Blizbor/KDAC/Hardware/Output/dac.pdf

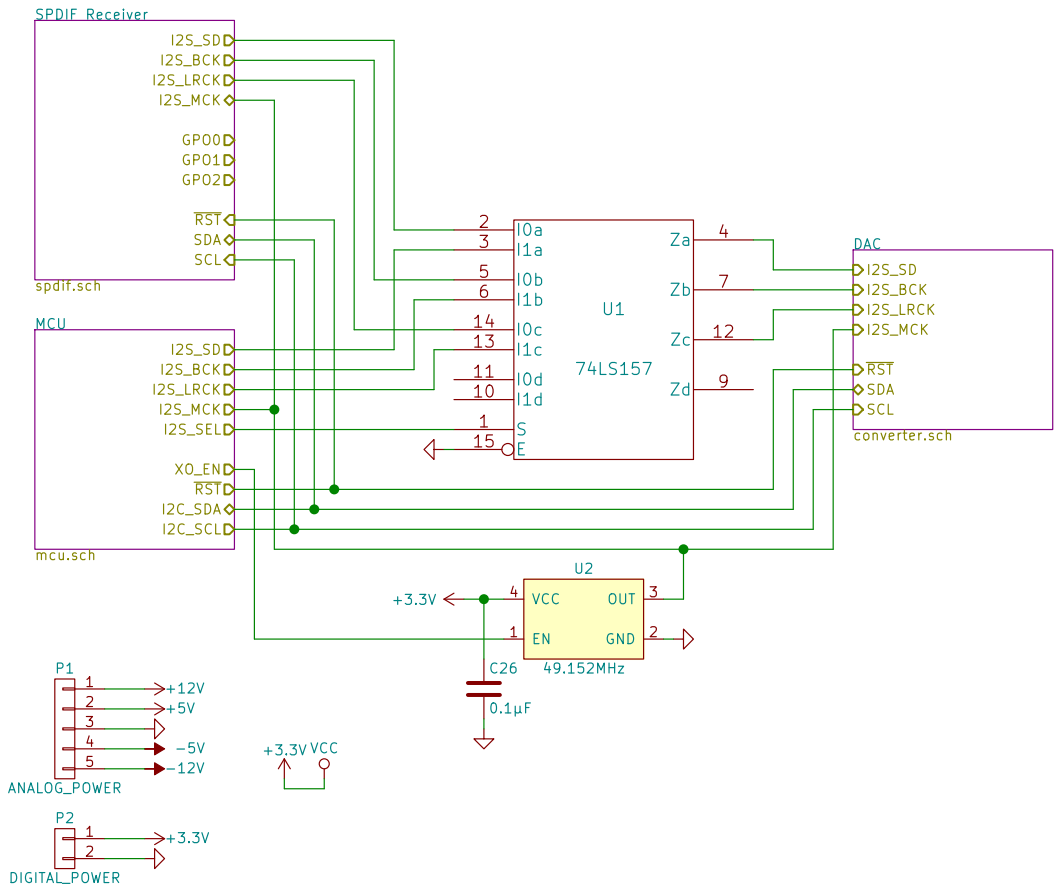
[picture p1: page 1]

File: dac.sch Sheet: / Kosyak CC BY-SA S

Id: 1/4 Title: KDAC - OpenSource USB Audio DAC

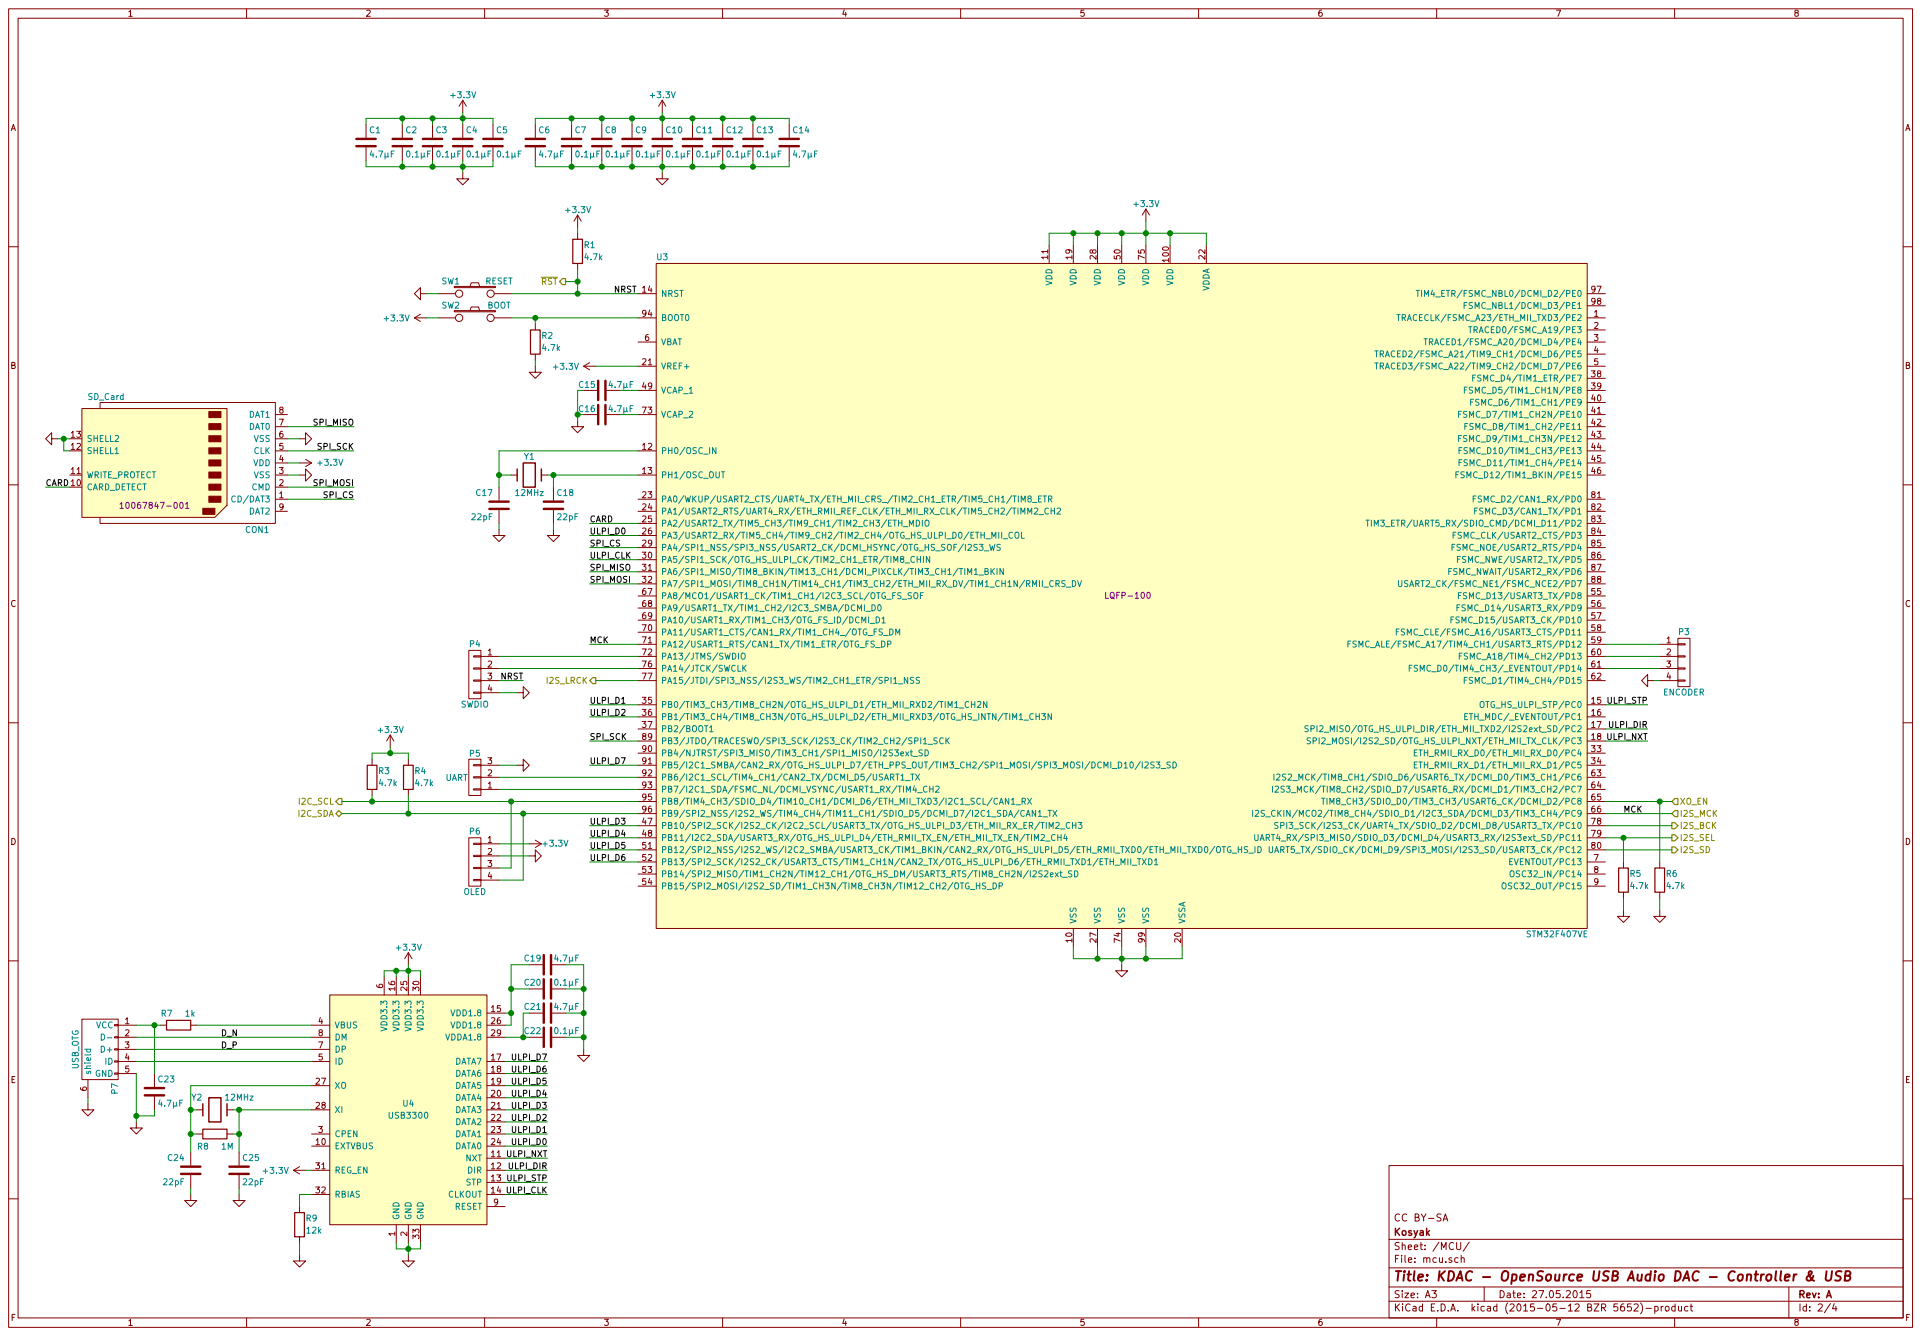
[picture p2: page 2]

6 DP 7 DM 8 RESET 9 EXTVBUS 10 DATA4 20 VDD3.3 30 NXT 11 DATA3 21 REG_EN 31 DIR 12 DATA2 22 RBIAS 32 STP 13 DATA1 23 GND 33 CLKOUT 14 DATA0 24 VDD1.8 15 VDD3.3 25 VDD3.3 16 VDD1.8 26 DATA7 17 XO 27 DATA6 18 XI 28 DATA5 19 VDDA1.8 29 U4 USB3300

File: mcu.sch Sheet: /MCU/ Kosyak CC BY-SA

Id: 2/4 Title: KDAC - OpenSource USB Audio DAC - Controller & USB

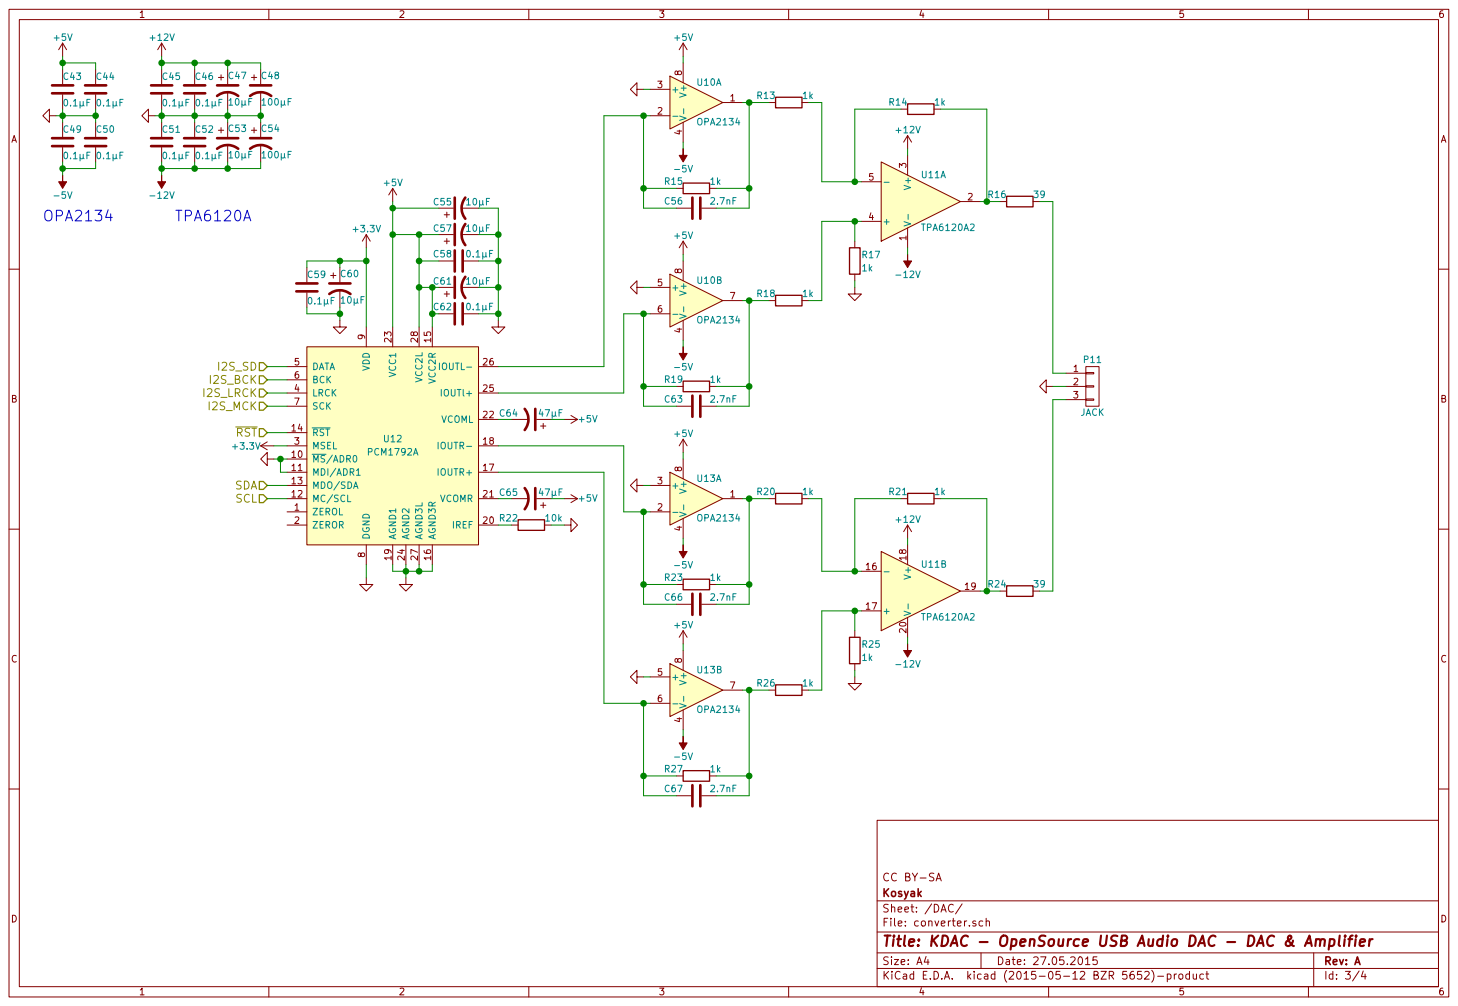
[picture p3: page 3]

Id: 3/4 Title: KDAC - OpenSource USB Audio DAC - DAC & Amplifier File: converter.sch Sheet: /DAC/ Kosyak CC BY-SA

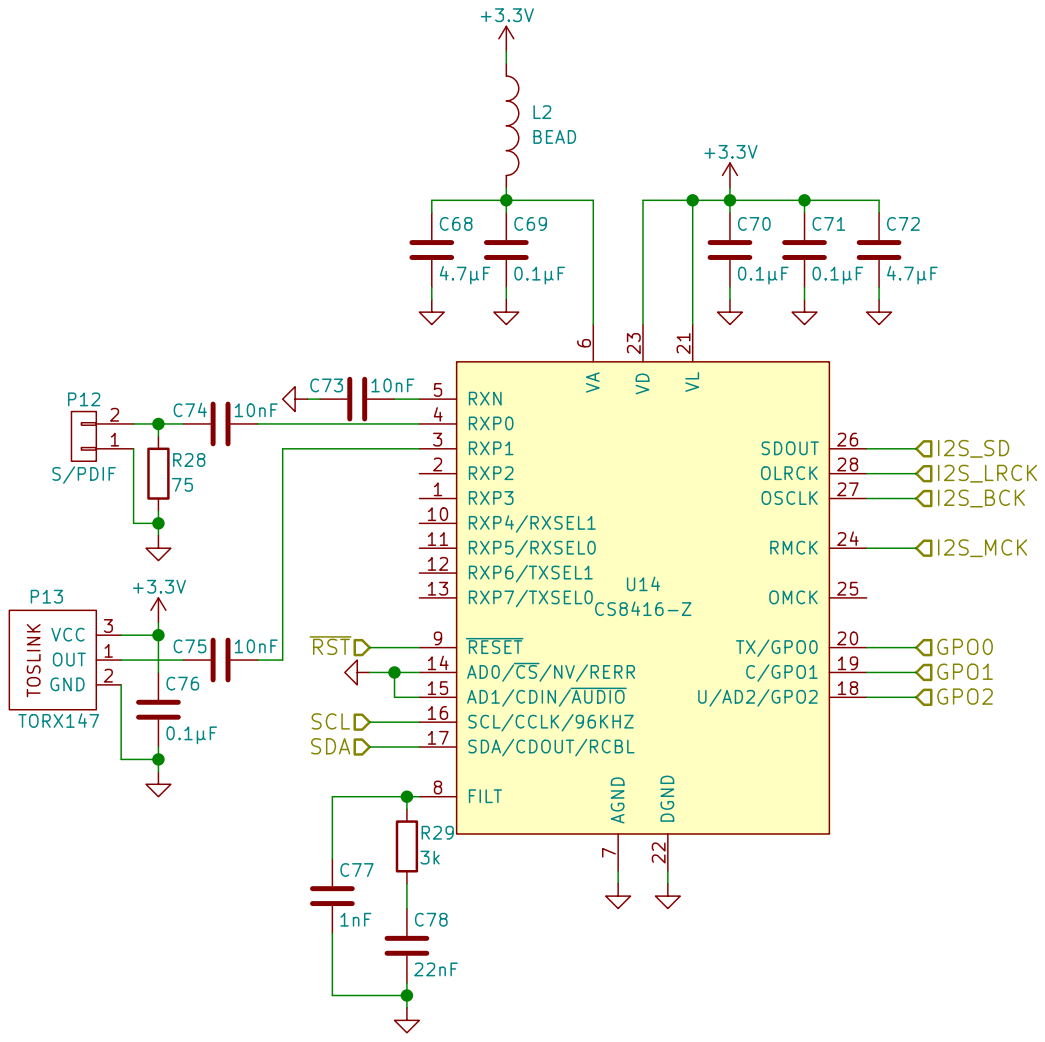
[picture p4: page 4]

7 FILT 8 RESET 9 RXP4/RXSEL1 10 TX/GPO0 20 RXP5/RXSEL0 11 VL 21 RXP6/TXSEL1 12 DGND 22 RXP7/TXSEL0 13 VD 23 AD0/CS/NV/RERR 14 RMCK 24 AD1/CDIN/AUDIO 15 OMCK 25 SCL/CCLK/96KHZ 16 SDOUT 26 SDA/CDOUT/RCBL 17 OSCLK 27 U/AD2/GPO2 18 OLRCK 28 C/GPO1 19 U14 CS8416-Z C69

File: spdif.sch Sheet: /SPDIF Receiver/ Kosyak CC BY-SA

Id: 4/4 Title: KDAC - OpenSource USB Audio DAC - S/PDIF Receiver
