Blizbor/KDAC/Hardware/dac.kicad_pcb

## KiCad design Hardware/dac.kicad_pcb (2015-05-27)

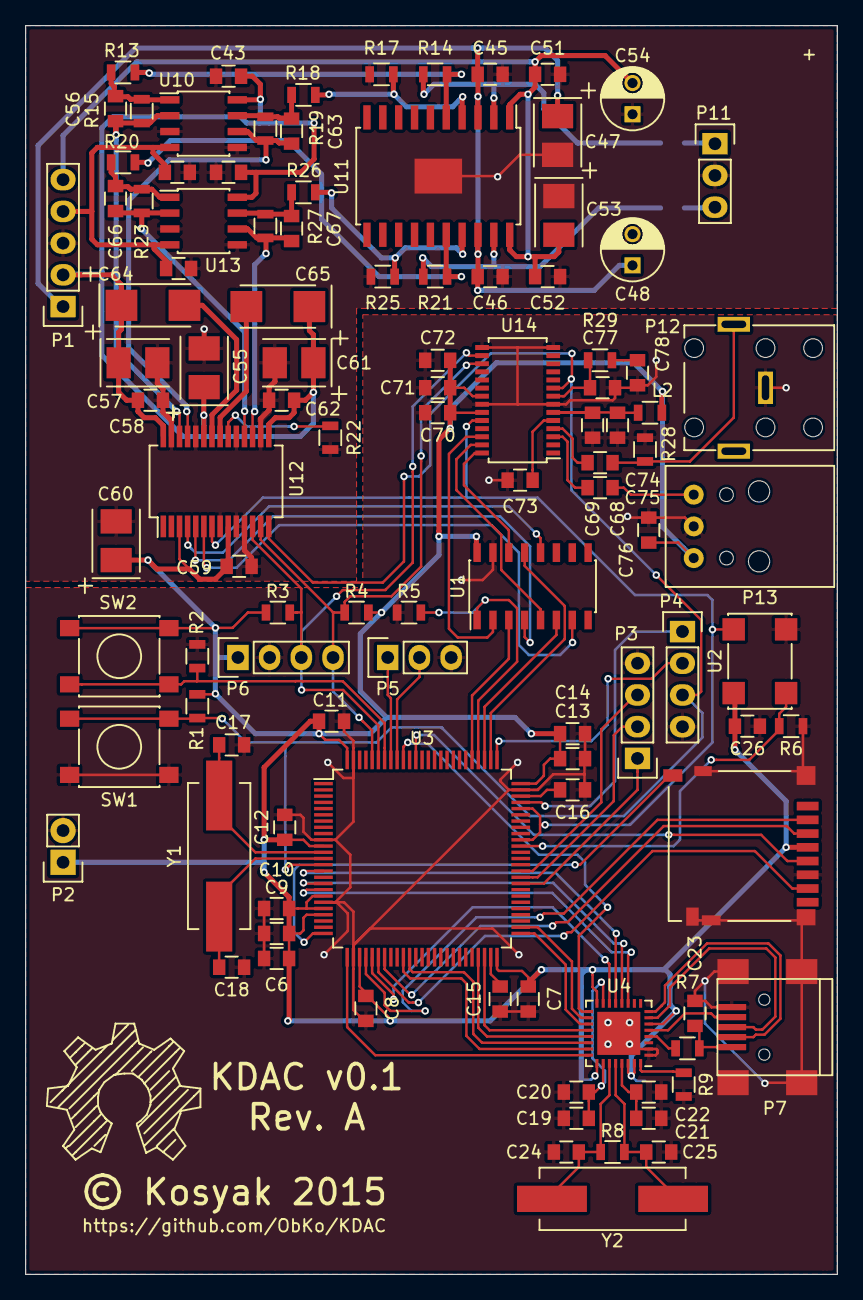
[picture p5: board dac.kicad_pcb from above]

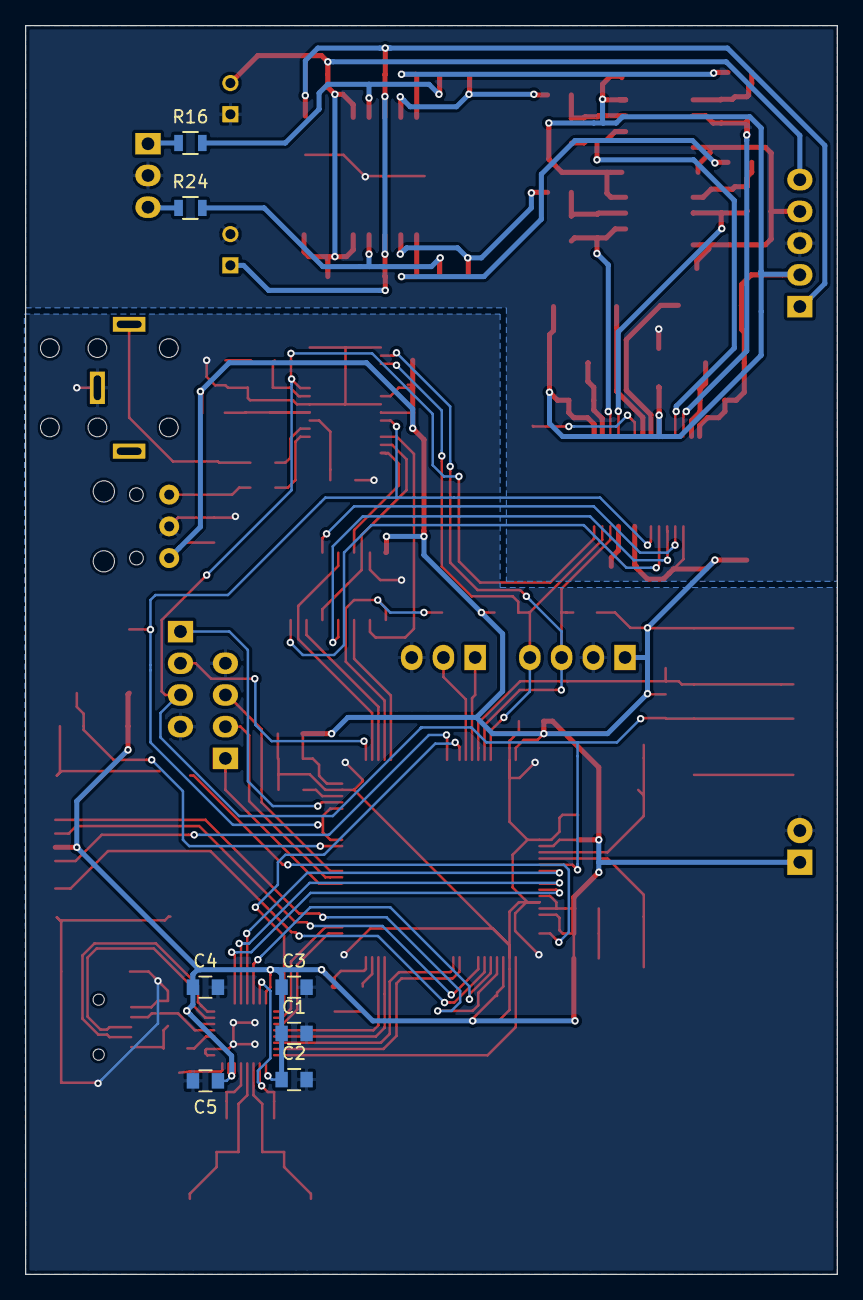
[picture p6: board dac.kicad_pcb from below]

Board: 2 copper layers, 65.0 x 100.0 mm, 113 parts (7 on the bottom side), 88 nets.

Parts:
C1, C6, C14, C15, C16, C19, C21, C23, C68, C72: 4.7µF; C_0805
C2, C3, C4, C5, C7, C8, C9, C10, C11, C12, C13, C20, C22, C26, C43, C44, C45, C46, C49, C50, C51, C52, C58, C59, C62, C69, C70, C71, C76: 0.1µF; C_0805
C17, C18, C24, C25: 22pF; C_0805
C47, C53, C55, C57, C60, C61: 10µF; TantalC_SizeB_EIA-3528_Reflow
C48, C54: 100µF; C_Radial_D5_L11_P2.5
C56, C63, C66, C67: 2.7nF; C_0805
C64, C65: 47µF; TantalC_SizeC_EIA-6032_Reflow
C73, C74, C75: 10nF; C_0805
C77: 1nF; C_0805
C78: 22nF; C_0805
CON1: SD_Card; DM3D-SF
L2: BEAD; R_0805
P1: ANALOG_POWER; Pin_Header_Straight_1x05
P2: DIGITAL_POWER; Pin_Header_Straight_1x02
P3: ENCODER; Pin_Header_Straight_1x04
P4: SWDIO; Pin_Header_Straight_1x04
P5: UART; Pin_Header_Straight_1x03
P6: OLED; Pin_Header_Straight_1x04
P7: USB_OTG; USB_Mini-B
P11: JACK; Pin_Header_Straight_1x03
P12: S/PDIF; RCA
P13: TORX147; TORX147PL
R1, R2, R3, R4, R5, R6: 4.7k; R_0805
R7, R13, R14, R15, R17, R18, R19, R20, R21, R23, R25, R26, R27: 1k; R_0805
R8: 1M; R_0805
R9: 12k; R_0805
R16, R24: 39; R_0805
R22: 10k; R_0805
R28: 75; R_0805
R29: 3k; R_0805
SW1: RESET; SW_SPST_PTS645
SW2: BOOT; SW_SPST_PTS645
U1: 74LS157; SOIC-16_3.9x9.9mm_Pitch1.27mm
U2: 49.152MHz; XO
U3: STM32F407VE; LQFP-100_14x14mm_Pitch0.5mm
U4: USB3300; QFN-32-1EP_5x5mm_Pitch0.5mm
U10, U13: OPA2134; SOIC-8_3.9x4.9mm_Pitch1.27mm
U11: TPA6120A2; SOIC-20_7.5x12.8mm_Pitch1.27mm
U12: PCM1792A; SSOP-28_5.3x10.2mm_Pitch0.65mm
U14: CS8416-Z; TSSOP-28_4.4x9.7mm_Pitch0.65mm
Y1, Y2: 12MHz; Crystal_HC49-SD_SMD

Connections:
+3V3: C1.1, C2.1, C3.1, C4.1, C5.1, C6.1, C7.1, C8.1, C9.1, C10.1, C11.1, C12.1, C13.1, C14.1, C26.1, C59.2, C60.1, C70.1, C71.1, C72.1, C76.1, CON1.4, L2.1, P2.1, P6.1, P13.3, R1.1, R3.1, R4.1, SW2.1, U1.16, U2.4, U3.11, U3.19, U3.21, U3.22, U3.28, U3.50, U3.75, U3.100, U4.6, U4.16, U4.25, U4.30, U4.31, U12.3, U12.9, U14.21, U14.23
+5V: C43.2, C44.2, C55.1, C57.1, C58.2, C61.1, C62.2, C64.1, C65.1, P1.2, U10.8, U12.15, U12.23, U12.28, U13.8
+12V: C45.2, C46.2, C47.1, C48.1, P1.1, U11.3, U11.18
-5V: C49.1, C50.1, P1.4, U10.4, U13.4
-12V: C51.1, C52.1, C53.2, C54.2, P1.5, U11.1, U11.20
/DAC/I2S_BCK: U1.7, U12.6
/DAC/I2S_LRCK: U1.12, U12.4
/DAC/I2S_MCK: U2.3, U3.66, U3.71, U12.7, U14.24
/DAC/I2S_SD: U1.4, U12.5
/DAC/~RST: P4.3, R1.2, SW1.2, U3.14, U12.14, U14.9
/MCU/CARD: CON1.10, U3.25
/MCU/D_N: P7.2, U4.8
/MCU/D_P: P7.3, U4.7
/MCU/I2C_SCL: P6.3, R3.2, U3.95, U12.12, U14.16
/MCU/I2C_SDA: P6.4, R4.2, U3.96, U12.13, U14.17
/MCU/I2S_BCK: U1.6, U3.78
/MCU/I2S_LRCK: U1.13, U3.77
/MCU/I2S_SD: U1.3, U3.80
/MCU/I2S_SEL: R5.1, U1.1, U3.79
/MCU/SPI_CS: CON1.1, U3.29
/MCU/SPI_MISO: CON1.7, U3.31
/MCU/SPI_MOSI: CON1.2, U3.32
/MCU/SPI_SCK: CON1.5, U3.89
/MCU/ULPI_CLK: U3.30, U4.14
/MCU/ULPI_D0: U3.26, U4.24
/MCU/ULPI_D1: U3.35, U4.23
/MCU/ULPI_D2: U3.36, U4.22
/MCU/ULPI_D3: U3.47, U4.21
/MCU/ULPI_D4: U3.48, U4.20
/MCU/ULPI_D5: U3.51, U4.19
/MCU/ULPI_D6: U3.52, U4.18
/MCU/ULPI_D7: U3.91, U4.17
/MCU/ULPI_DIR: U3.17, U4.12
/MCU/ULPI_NXT: U3.18, U4.11
/MCU/ULPI_STP: U3.15, U4.13
/MCU/XO_EN: R6.1, U2.1, U3.65
/SPDIF Receiver/I2S_BCK: U1.5, U14.27
/SPDIF Receiver/I2S_LRCK: U1.14, U14.28
/SPDIF Receiver/I2S_SD: U1.2, U14.26
GNDA: C43.1, C44.1, C45.1, C46.1, C47.2, C48.2, C49.2, C50.2, C51.2, C52.2, C53.1, C54.1, C55.2, C57.2, C58.1, C59.1, C60.2, C61.2, C62.1, P1.3, P11.2, R17.1, R22.1, R25.1, U10.3, U10.5, U12.8, U12.10, U12.11, U12.16, U12.19, U12.24, U12.27, U13.3, U13.5
GNDD: C1.2, C2.2, C3.2, C4.2, C5.2, C6.2, C7.2, C8.2, C9.2, C10.2, C11.2, C12.2, C13.2, C14.2, C15.1, C16.1, C17.2, C18.2, C19.1, C20.1, C21.1, C22.1, C23.2, C24.2, C25.2, C26.2, C68.2, C69.2, C70.2, C71.2, C72.2, C73.2, C76.2, C77.2, C78.2, CON1.6, CON1.12, P2.2, P3.4, P4.4, P5.3, P6.2, P7.5, P7.6, P12.1, P13.2, R2.2, R5.2, R6.2, R9.2, R28.2, SW1.1, U1.15, U2.2, U3.10, U3.20, U3.27, U3.74, U3.99, U4.1, U4.2, U4.33, U14.7, U14.14, U14.15, U14.22
unnamed: C15.2, U3.49
unnamed: C16.2, U3.73
unnamed: C17.1, U3.12, Y1.1
unnamed: C18.1, U3.13, Y1.2
unnamed: C19.2, C20.2, U4.15, U4.26
unnamed: C21.2, C22.2, U4.29
unnamed: C23.1, P7.1, R7.1
unnamed: C24.1, R8.1, U4.27, Y2.1
unnamed: C25.1, R8.2, U4.28, Y2.2
unnamed: C56.1, R13.2, R15.1, U10.1
unnamed: C56.2, R15.2, U10.2, U12.26
unnamed: C63.1, R18.2, R19.1, U10.7
unnamed: C63.2, R19.2, U10.6, U12.25
unnamed: C64.2, U12.22
unnamed: C65.2, U12.21
unnamed: C66.1, R20.2, R23.1, U13.1
unnamed: C66.2, R23.2, U12.18, U13.2
unnamed: C67.1, R26.2, R27.1, U13.7
unnamed: C67.2, R27.2, U12.17, U13.6
unnamed: C68.1, C69.1, L2.2, U14.6
unnamed: C73.1, U14.5
unnamed: C74.1, U14.4
unnamed: C74.2, P12.2, R28.1
unnamed: C75.1, U14.3
unnamed: C75.2, P13.1
unnamed: C77.1, R29.1, U14.8
unnamed: C78.1, R29.2
unnamed: P3.1, U3.59
unnamed: P3.2, U3.60
unnamed: P3.3, U3.61
unnamed: P4.1, U3.72
unnamed: P4.2, U3.76
unnamed: P5.1, U3.93
unnamed: P5.2, U3.92
unnamed: P7.4, U4.5
unnamed: P11.1, R16.1
unnamed: P11.3, R24.1
unnamed: R2.1, SW2.2, U3.94
unnamed: R7.2, U4.4
unnamed: R9.1, U4.32
unnamed: R13.1, R14.2, U11.5
unnamed: R14.1, R16.2, U11.2
unnamed: R17.2, R18.1, U11.4
unnamed: R20.1, R21.2, U11.16
unnamed: R21.1, R24.2, U11.19
unnamed: R22.2, U12.20
unnamed: R25.2, R26.1, U11.17
