Blizbor/KDAC/Hardware/power.kicad_pcb

## KiCad design Hardware/power.kicad_pcb (2015-05-27)

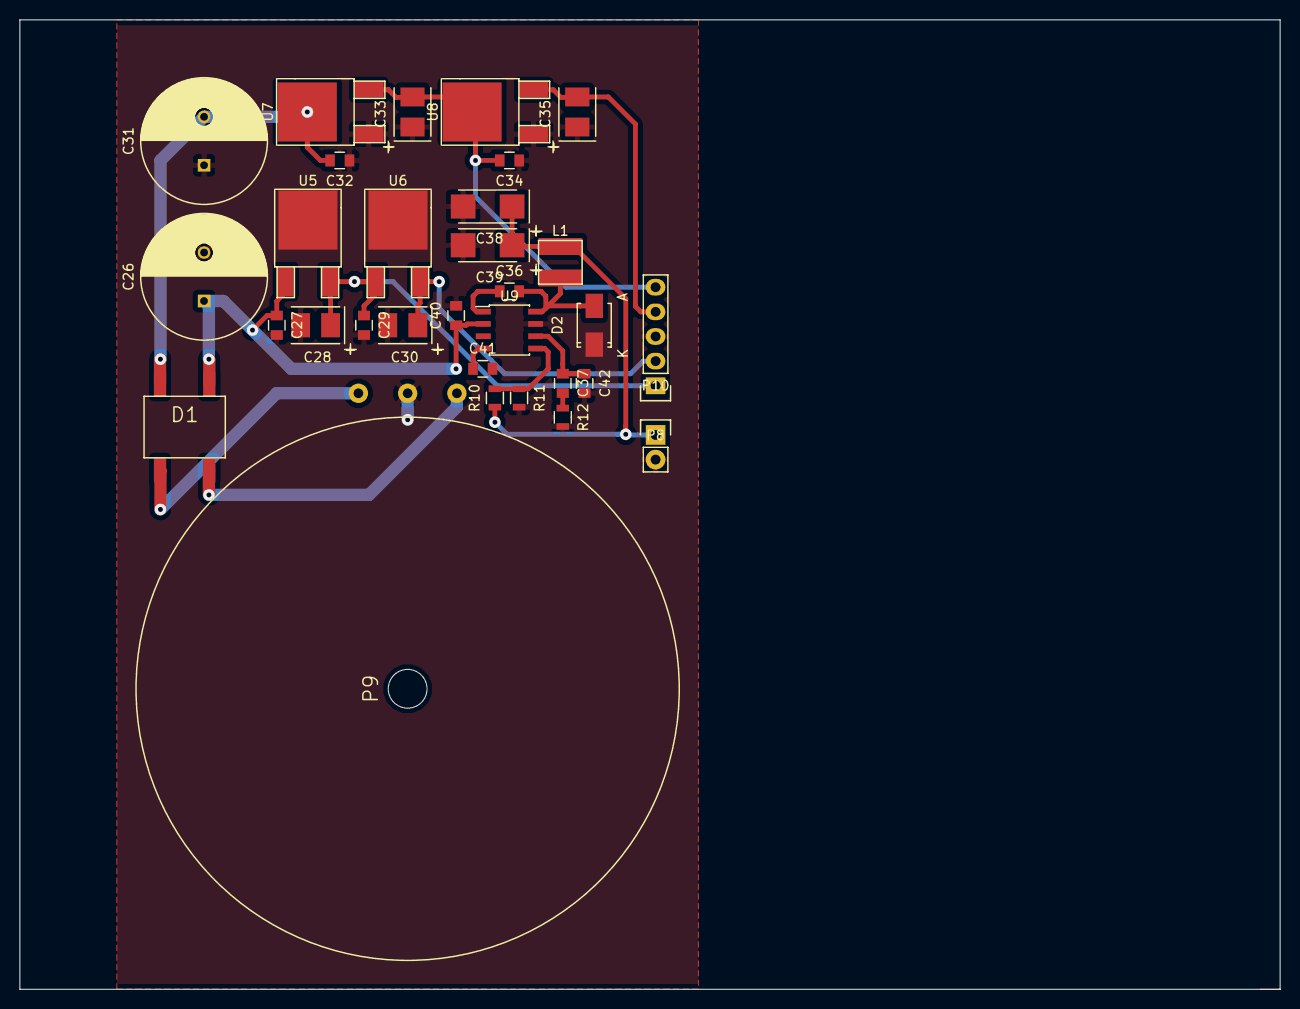
[picture p7: board power.kicad_pcb from above]

Board: 2 copper layers, 130.0 x 100.0 mm, 31 parts (0 on the bottom side), 16 nets.

Parts:
C26, C31: 1000µF; C_Radial_D13_L21_P5
C27, C29, C32, C34, C36: 0.1µF; C_0805
C28, C30, C33, C35: 10µF; TantalC_SizeB_EIA-3528_Reflow
C37: ~1nF; C_0805
C38, C39: 47µF; TantalC_SizeC_EIA-6032_Reflow
C40: 4.7µF; C_0805
C41: 10nF; C_0805
C42: ~47pF; C_0805
D1: D_Bridge; DB10xS
D2: SS14; Diode-SMA_Standard
L1: 47µH; CD43
P8: ANALOG_POWER; Pin_Header_Straight_1x05
P9: TRANSFORMER; TTP-15
P10: DIGITAL_POWER; Pin_Header_Straight_1x02
R10: 7.5k; R_0805
R11: 2.4k; R_0805
R12: 33k; R_0805
U5: 7812; DPAK-2
U6: 7805; DPAK-2
U7: 7912; DPAK-2
U8: 7905; DPAK-2
U9: TPS54331; SOIC-8_3.9x4.9mm_Pitch1.27mm

Connections:
+3V3: C38.1, C39.1, L1.2, P10.1, R10.1
+5V: C30.1, P8.2, U6.3
+12V: C28.1, C29.1, P8.1, U5.3, U6.1
-5V: C35.2, P8.4, U8.3
-12V: C33.2, C34.2, P8.5, U7.3, U8.2
GNDD: C26.2, C27.2, C28.2, C29.2, C30.2, C31.1, C32.1, C33.1, C34.1, C35.1, C38.2, C39.2, C40.2, C41.2, C42.2, D2.1, P8.3, P9.2, P10.2, R11.2, R12.2, U5.2, U6.2, U7.1, U8.1, U9.7
unnamed: C26.1, C27.1, C40.1, D1.3, U5.1, U9.2
unnamed: C31.2, C32.2, D1.4, U7.2
unnamed: C36.1, U9.1
unnamed: C36.2, D2.2, L1.1, U9.8
unnamed: C37.1, C42.1, U9.6
unnamed: C37.2, R12.1
unnamed: C41.1, U9.4
unnamed: D1.1, P9.1
unnamed: D1.2, P9.3
unnamed: R10.2, R11.1, U9.5
