Blizbor/KDAC/Software/board.h

/*
    ChibiOS - Copyright (C) 2006..2015 Giovanni Di Sirio

    Licensed under the Apache License, Version 2.0 (the "License");
    you may not use this file except in compliance with the License.
    You may obtain a copy of the License at

        http://www.apache.org/licenses/LICENSE-2.0

    Unless required by applicable law or agreed to in writing, software
    distributed under the License is distributed on an "AS IS" BASIS,
    WITHOUT WARRANTIES OR CONDITIONS OF ANY KIND, either express or implied.
    See the License for the specific language governing permissions and
    limitations under the License.
*/

#ifndef _BOARD_H_
#define _BOARD_H_

/*
 * Setup for KDAC board board.
 */

/*
 * Board identifier.
 */
#define BOARD_BOARD_KDAC
#define BOARD_NAME                  "KDAC board"

/*
 * Ethernet PHY type.
 */
#define BOARD_PHY_ID                MII_KS8721_ID
#define BOARD_PHY_RMII

/*
* The board has an ULPI USB PHY.
*/
#define BOARD_OTG2_USES_ULPI

/*
 * Board oscillators-related settings.
 */
#if !defined(STM32_LSECLK)
#define STM32_LSECLK                32768U
#endif

#if !defined(STM32_HSECLK)
#define STM32_HSECLK                12000000U
#endif

/*
 * Board voltages.
 * Required for performance limits calculation.
 */
#define STM32_VDD                   330U

/*
 * MCU type as defined in the ST header.
 */
//#define STM32F407xx

/*
 * IO pins assignments.
 */
#define GPIOA_PIN0                  0U
#define GPIOA_PIN1                  1U
#define GPIOA_CARD_DETECT           2U
#define GPIOA_ULPI_D0               3U
#define GPIOA_CARD_CS               4U
#define GPIOA_ULPI_CLK              5U
#define GPIOA_CARD_MISO             6U
#define GPIOA_CARD_MOSI             7U
#define GPIOA_PIN8                  8U
#define GPIOA_PIN9                  9U
#define GPIOA_PIN10                 10U
#define GPIOA_PIN11                 11U
#define GPIOA_MCK_FB                12U
#define GPIOA_JTAG_TMS              13U
#define GPIOA_JTAG_TCK              14U
#define GPIOA_I2S_LRCK              15U

#define GPIOB_ULPI_D1               0U
#define GPIOB_ULPI_D2               1U
#define GPIOB_PIN2                  2U
#define GPIOB_CARD_SCK              3U
#define GPIOB_PIN4                  4U
#define GPIOB_ULPI_D7               5U
#define GPIOB_USART1_TX             6U
#define GPIOB_USART1_RX             7U
#define GPIOB_I2C_SCL               8U
#define GPIOB_I2C_SDA               9U
#define GPIOB_ULPI_D3               10U
#define GPIOB_ULPI_D4               11U
#define GPIOB_ULPI_D5               12U
#define GPIOB_ULPI_D6               13U
#define GPIOB_PIN14                 14U
#define GPIOB_PIN15                 15U

#define GPIOC_ULPI_STP              0U
#define GPIOC_PIN1                  1U
#define GPIOC_ULPI_DIR              2U
#define GPIOC_ULPI_NXT              3U
#define GPIOC_PIN4                  4U
#define GPIOC_PIN5                  5U
#define GPIOC_PIN6                  6U
#define GPIOC_PIN7                  7U
#define GPIOC_MCK_EN                8U
#define GPIOC_I2S_MCK               9U
#define GPIOC_I2S_BCK               10U
#define GPIOC_I2S_SEL               11U
#define GPIOC_I2S_SD                12U
#define GPIOC_PIN13                 13U
#define GPIOC_PIN14                 14U
#define GPIOC_PIN15                 15U

#define GPIOD_PIN0                  0U
#define GPIOD_PIN1                  1U
#define GPIOD_PIN2                  2U
#define GPIOD_PIN3                  3U
#define GPIOD_PIN4                  4U
#define GPIOD_PIN5                  5U
#define GPIOD_PIN6                  6U
#define GPIOD_PIN7                  7U
#define GPIOD_PIN8                  8U
#define GPIOD_PIN9                  9U
#define GPIOD_PIN10                 10U
#define GPIOD_PIN11                 11U
#define GPIOD_ENCODER_LEFT          12U
#define GPIOD_ENCODER_RIGHT         13U
#define GPIOD_ENCODER_CLICK         14U
#define GPIOD_PIN15                 15U

#define GPIOE_PIN0                  0U
#define GPIOE_PIN1                  1U
#define GPIOE_PIN2                  2U
#define GPIOE_PIN3                  3U
#define GPIOE_PIN4                  4U
#define GPIOE_PIN5                  5U
#define GPIOE_PIN6                  6U
#define GPIOE_PIN7                  7U
#define GPIOE_PIN8                  8U
#define GPIOE_PIN9                  9U
#define GPIOE_PIN10                 10U
#define GPIOE_PIN11                 11U
#define GPIOE_PIN12                 12U
#define GPIOE_PIN13                 13U
#define GPIOE_PIN14                 14U
#define GPIOE_PIN15                 15U

#define GPIOF_PIN0                  0U
#define GPIOF_PIN1                  1U
#define GPIOF_PIN2                  2U
#define GPIOF_PIN3                  3U
#define GPIOF_PIN4                  4U
#define GPIOF_PIN5                  5U
#define GPIOF_PIN6                  6U
#define GPIOF_PIN7                  7U
#define GPIOF_PIN8                  8U
#define GPIOF_PIN9                  9U
#define GPIOF_PIN10                 10U
#define GPIOF_PIN11                 11U
#define GPIOF_PIN12                 12U
#define GPIOF_PIN13                 13U
#define GPIOF_PIN14                 14U
#define GPIOF_PIN15                 15U

#define GPIOG_PIN0                  0U
#define GPIOG_PIN1                  1U
#define GPIOG_PIN2                  2U
#define GPIOG_PIN3                  3U
#define GPIOG_PIN4                  4U
#define GPIOG_PIN5                  5U
#define GPIOG_PIN6                  6U
#define GPIOG_PIN7                  7U
#define GPIOG_PIN8                  8U
#define GPIOG_PIN9                  9U
#define GPIOG_PIN10                 10U
#define GPIOG_PIN11                 11U
#define GPIOG_PIN12                 12U
#define GPIOG_PIN13                 13U
#define GPIOG_PIN14                 14U
#define GPIOG_PIN15                 15U

#define GPIOH_OSC_IN                0U
#define GPIOH_OSC_OUT               1U
#define GPIOH_PIN2                  2U
#define GPIOH_PIN3                  3U
#define GPIOH_PIN4                  4U
#define GPIOH_PIN5                  5U
#define GPIOH_PIN6                  6U
#define GPIOH_PIN7                  7U
#define GPIOH_PIN8                  8U
#define GPIOH_PIN9                  9U
#define GPIOH_PIN10                 10U
#define GPIOH_PIN11                 11U
#define GPIOH_PIN12                 12U
#define GPIOH_PIN13                 13U
#define GPIOH_PIN14                 14U
#define GPIOH_PIN15                 15U

#define GPIOI_PIN0                  0U
#define GPIOI_PIN1                  1U
#define GPIOI_PIN2                  2U
#define GPIOI_PIN3                  3U
#define GPIOI_PIN4                  4U
#define GPIOI_PIN5                  5U
#define GPIOI_PIN6                  6U
#define GPIOI_PIN7                  7U
#define GPIOI_PIN8                  8U
#define GPIOI_PIN9                  9U
#define GPIOI_PIN10                 10U
#define GPIOI_PIN11                 11U
#define GPIOI_PIN12                 12U
#define GPIOI_PIN13                 13U
#define GPIOI_PIN14                 14U
#define GPIOI_PIN15                 15U

/*
 * I/O ports initial setup, this configuration is established soon after reset
 * in the initialization code.
 * Please refer to the STM32 Reference Manual for details.
 */
#define PIN_MODE_INPUT(n)           (0U << ((n) * 2U))
#define PIN_MODE_OUTPUT(n)          (1U << ((n) * 2U))
#define PIN_MODE_ALTERNATE(n)       (2U << ((n) * 2U))
#define PIN_MODE_ANALOG(n)          (3U << ((n) * 2U))
#define PIN_ODR_LOW(n)              (0U << (n))
#define PIN_ODR_HIGH(n)             (1U << (n))
#define PIN_OTYPE_PUSHPULL(n)       (0U << (n))
#define PIN_OTYPE_OPENDRAIN(n)      (1U << (n))
#define PIN_OSPEED_2M(n)            (0U << ((n) * 2U))
#define PIN_OSPEED_25M(n)           (1U << ((n) * 2U))
#define PIN_OSPEED_50M(n)           (2U << ((n) * 2U))
#define PIN_OSPEED_100M(n)          (3U << ((n) * 2U))
#define PIN_PUPDR_FLOATING(n)       (0U << ((n) * 2U))
#define PIN_PUPDR_PULLUP(n)         (1U << ((n) * 2U))
#define PIN_PUPDR_PULLDOWN(n)       (2U << ((n) * 2U))
#define PIN_AFIO_AF(n, v)           ((v) << (((n) % 8U) * 4U))

/*
 * GPIOA setup:
 *
 * PA0  - PIN0                      (input pullup).
 * PA1  - PIN1                      (input pullup).
 * PA2  - CARD_DETECT               (input pullup).
 * PA3  - ULPI_D0                   (alternate 10).
 * PA4  - CARD_CS                   (output pushpull maximum).
 * PA5  - ULPI_CLK                  (alternate 10).
 * PA6  - CARD_MISO                 (alternate 5).
 * PA7  - CARD_MOSI                 (alternate 5).
 * PA8  - PIN8                      (input pullup).
 * PA9  - PIN9                      (input pullup).
 * PA10 - PIN10                     (input pullup).
 * PA11 - PIN11                     (input pullup).
 * PA12 - MCK_FB                    (alternate 1).
 * PA13 - JTAG_TMS                  (alternate 0).
 * PA14 - JTAG_TCK                  (alternate 0).
 * PA15 - I2S_LRCK                  (alternate 6).
 */
#define VAL_GPIOA_MODER             (PIN_MODE_INPUT(GPIOA_PIN0) |           \
                                     PIN_MODE_INPUT(GPIOA_PIN1) |           \
                                     PIN_MODE_INPUT(GPIOA_CARD_DETECT) |    \
                                     PIN_MODE_ALTERNATE(GPIOA_ULPI_D0) |    \
                                     PIN_MODE_OUTPUT(GPIOA_CARD_CS) |       \
                                     PIN_MODE_ALTERNATE(GPIOA_ULPI_CLK) |   \
                                     PIN_MODE_ALTERNATE(GPIOA_CARD_MISO) |  \
                                     PIN_MODE_ALTERNATE(GPIOA_CARD_MOSI) |  \
                                     PIN_MODE_INPUT(GPIOA_PIN8) |           \
                                     PIN_MODE_INPUT(GPIOA_PIN9) |           \
                                     PIN_MODE_INPUT(GPIOA_PIN10) |          \
                                     PIN_MODE_INPUT(GPIOA_PIN11) |          \
                                     PIN_MODE_ALTERNATE(GPIOA_MCK_FB) |     \
                                     PIN_MODE_ALTERNATE(GPIOA_JTAG_TMS) |   \
                                     PIN_MODE_ALTERNATE(GPIOA_JTAG_TCK) |   \
                                     PIN_MODE_ALTERNATE(GPIOA_I2S_LRCK))
#define VAL_GPIOA_OTYPER            (PIN_OTYPE_PUSHPULL(GPIOA_PIN0) |       \
                                     PIN_OTYPE_PUSHPULL(GPIOA_PIN1) |       \
                                     PIN_OTYPE_PUSHPULL(GPIOA_CARD_DETECT) |\
                                     PIN_OTYPE_PUSHPULL(GPIOA_ULPI_D0) |    \
                                     PIN_OTYPE_PUSHPULL(GPIOA_CARD_CS) |    \
                                     PIN_OTYPE_PUSHPULL(GPIOA_ULPI_CLK) |   \
                                     PIN_OTYPE_PUSHPULL(GPIOA_CARD_MISO) |  \
                                     PIN_OTYPE_PUSHPULL(GPIOA_CARD_MOSI) |  \
                                     PIN_OTYPE_PUSHPULL(GPIOA_PIN8) |       \
                                     PIN_OTYPE_PUSHPULL(GPIOA_PIN9) |       \
                                     PIN_OTYPE_PUSHPULL(GPIOA_PIN10) |      \
                                     PIN_OTYPE_PUSHPULL(GPIOA_PIN11) |      \
                                     PIN_OTYPE_PUSHPULL(GPIOA_MCK_FB) |     \
                                     PIN_OTYPE_PUSHPULL(GPIOA_JTAG_TMS) |   \
                                     PIN_OTYPE_PUSHPULL(GPIOA_JTAG_TCK) |   \
                                     PIN_OTYPE_PUSHPULL(GPIOA_I2S_LRCK))
#define VAL_GPIOA_OSPEEDR           (PIN_OSPEED_2M(GPIOA_PIN0) |            \
                                     PIN_OSPEED_2M(GPIOA_PIN1) |            \
                                     PIN_OSPEED_2M(GPIOA_CARD_DETECT) |     \
                                     PIN_OSPEED_100M(GPIOA_ULPI_D0) |       \
                                     PIN_OSPEED_100M(GPIOA_CARD_CS) |       \
                                     PIN_OSPEED_100M(GPIOA_ULPI_CLK) |      \
                                     PIN_OSPEED_100M(GPIOA_CARD_MISO) |     \
                                     PIN_OSPEED_100M(GPIOA_CARD_MOSI) |     \
                                     PIN_OSPEED_2M(GPIOA_PIN8) |            \
                                     PIN_OSPEED_2M(GPIOA_PIN9) |            \
                                     PIN_OSPEED_2M(GPIOA_PIN10) |           \
                                     PIN_OSPEED_2M(GPIOA_PIN11) |           \
                                     PIN_OSPEED_100M(GPIOA_MCK_FB) |        \
                                     PIN_OSPEED_100M(GPIOA_JTAG_TMS) |      \
                                     PIN_OSPEED_100M(GPIOA_JTAG_TCK) |      \
                                     PIN_OSPEED_100M(GPIOA_I2S_LRCK))
#define VAL_GPIOA_PUPDR             (PIN_PUPDR_PULLUP(GPIOA_PIN0) |         \
                                     PIN_PUPDR_PULLUP(GPIOA_PIN1) |         \
                                     PIN_PUPDR_PULLUP(GPIOA_CARD_DETECT) |  \
                                     PIN_PUPDR_FLOATING(GPIOA_ULPI_D0) |    \
                                     PIN_PUPDR_FLOATING(GPIOA_CARD_CS) |    \
                                     PIN_PUPDR_FLOATING(GPIOA_ULPI_CLK) |   \
                                     PIN_PUPDR_PULLUP(GPIOA_CARD_MISO) |    \
                                     PIN_PUPDR_FLOATING(GPIOA_CARD_MOSI) |  \
                                     PIN_PUPDR_PULLUP(GPIOA_PIN8) |         \
                                     PIN_PUPDR_PULLUP(GPIOA_PIN9) |         \
                                     PIN_PUPDR_PULLUP(GPIOA_PIN10) |        \
                                     PIN_PUPDR_PULLUP(GPIOA_PIN11) |        \
                                     PIN_PUPDR_FLOATING(GPIOA_MCK_FB) |     \
                                     PIN_PUPDR_PULLUP(GPIOA_JTAG_TMS) |     \
                                     PIN_PUPDR_PULLDOWN(GPIOA_JTAG_TCK) |   \
                                     PIN_PUPDR_FLOATING(GPIOA_I2S_LRCK))
#define VAL_GPIOA_ODR               (PIN_ODR_HIGH(GPIOA_PIN0) |             \
                                     PIN_ODR_HIGH(GPIOA_PIN1) |             \
                                     PIN_ODR_HIGH(GPIOA_CARD_DETECT) |      \
                                     PIN_ODR_HIGH(GPIOA_ULPI_D0) |          \
                                     PIN_ODR_HIGH(GPIOA_CARD_CS) |          \
                                     PIN_ODR_HIGH(GPIOA_ULPI_CLK) |         \
                                     PIN_ODR_HIGH(GPIOA_CARD_MISO) |        \
                                     PIN_ODR_HIGH(GPIOA_CARD_MOSI) |        \
                                     PIN_ODR_HIGH(GPIOA_PIN8) |             \
                                     PIN_ODR_HIGH(GPIOA_PIN9) |             \
                                     PIN_ODR_HIGH(GPIOA_PIN10) |            \
                                     PIN_ODR_HIGH(GPIOA_PIN11) |            \
                                     PIN_ODR_HIGH(GPIOA_MCK_FB) |           \
                                     PIN_ODR_HIGH(GPIOA_JTAG_TMS) |         \
                                     PIN_ODR_HIGH(GPIOA_JTAG_TCK) |         \
                                     PIN_ODR_HIGH(GPIOA_I2S_LRCK))
#define VAL_GPIOA_AFRL              (PIN_AFIO_AF(GPIOA_PIN0, 0) |           \
                                     PIN_AFIO_AF(GPIOA_PIN1, 0) |           \
                                     PIN_AFIO_AF(GPIOA_CARD_DETECT, 0) |    \
                                     PIN_AFIO_AF(GPIOA_ULPI_D0, 10) |       \
                                     PIN_AFIO_AF(GPIOA_CARD_CS, 0) |        \
                                     PIN_AFIO_AF(GPIOA_ULPI_CLK, 10) |      \
                                     PIN_AFIO_AF(GPIOA_CARD_MISO, 5) |      \
                                     PIN_AFIO_AF(GPIOA_CARD_MOSI, 5))
#define VAL_GPIOA_AFRH              (PIN_AFIO_AF(GPIOA_PIN8, 0) |           \
                                     PIN_AFIO_AF(GPIOA_PIN9, 0) |           \
                                     PIN_AFIO_AF(GPIOA_PIN10, 0) |          \
                                     PIN_AFIO_AF(GPIOA_PIN11, 0) |          \
                                     PIN_AFIO_AF(GPIOA_MCK_FB, 1) |         \
                                     PIN_AFIO_AF(GPIOA_JTAG_TMS, 0) |       \
                                     PIN_AFIO_AF(GPIOA_JTAG_TCK, 0) |       \
                                     PIN_AFIO_AF(GPIOA_I2S_LRCK, 6))

/*
 * GPIOB setup:
 *
 * PB0  - ULPI_D1                   (alternate 10).
 * PB1  - ULPI_D2                   (alternate 10).
 * PB2  - PIN2                      (input pullup).
 * PB3  - CARD_SCK                  (alternate 5).
 * PB4  - PIN4                      (input pullup).
 * PB5  - ULPI_D7                   (alternate 10).
 * PB6  - USART1_TX                 (alternate 7).
 * PB7  - USART1_RX                 (alternate 7).
 * PB8  - I2C_SCL                   (alternate 4).
 * PB9  - I2C_SDA                   (alternate 4).
 * PB10 - ULPI_D3                   (alternate 10).
 * PB11 - ULPI_D4                   (alternate 10).
 * PB12 - ULPI_D5                   (alternate 10).
 * PB13 - ULPI_D6                   (alternate 10).
 * PB14 - PIN14                     (input pullup).
 * PB15 - PIN15                     (input pullup).
 */
#define VAL_GPIOB_MODER             (PIN_MODE_ALTERNATE(GPIOB_ULPI_D1) |    \
                                     PIN_MODE_ALTERNATE(GPIOB_ULPI_D2) |    \
                                     PIN_MODE_INPUT(GPIOB_PIN2) |           \
                                     PIN_MODE_ALTERNATE(GPIOB_CARD_SCK) |   \
                                     PIN_MODE_INPUT(GPIOB_PIN4) |           \
                                     PIN_MODE_ALTERNATE(GPIOB_ULPI_D7) |    \
                                     PIN_MODE_ALTERNATE(GPIOB_USART1_TX) |  \
                                     PIN_MODE_ALTERNATE(GPIOB_USART1_RX) |  \
                                     PIN_MODE_ALTERNATE(GPIOB_I2C_SCL) |    \
                                     PIN_MODE_ALTERNATE(GPIOB_I2C_SDA) |    \
                                     PIN_MODE_ALTERNATE(GPIOB_ULPI_D3) |    \
                                     PIN_MODE_ALTERNATE(GPIOB_ULPI_D4) |    \
                                     PIN_MODE_ALTERNATE(GPIOB_ULPI_D5) |    \
                                     PIN_MODE_ALTERNATE(GPIOB_ULPI_D6) |    \
                                     PIN_MODE_INPUT(GPIOB_PIN14) |          \
                                     PIN_MODE_INPUT(GPIOB_PIN15))
#define VAL_GPIOB_OTYPER            (PIN_OTYPE_PUSHPULL(GPIOB_ULPI_D1) |    \
                                     PIN_OTYPE_PUSHPULL(GPIOB_ULPI_D2) |    \
                                     PIN_OTYPE_PUSHPULL(GPIOB_PIN2) |       \
                                     PIN_OTYPE_PUSHPULL(GPIOB_CARD_SCK) |   \
                                     PIN_OTYPE_PUSHPULL(GPIOB_PIN4) |       \
                                     PIN_OTYPE_PUSHPULL(GPIOB_ULPI_D7) |    \
                                     PIN_OTYPE_PUSHPULL(GPIOB_USART1_TX) |  \
                                     PIN_OTYPE_PUSHPULL(GPIOB_USART1_RX) |  \
                                     PIN_OTYPE_OPENDRAIN(GPIOB_I2C_SCL) |   \
                                     PIN_OTYPE_OPENDRAIN(GPIOB_I2C_SDA) |   \
                                     PIN_OTYPE_PUSHPULL(GPIOB_ULPI_D3) |    \
                                     PIN_OTYPE_PUSHPULL(GPIOB_ULPI_D4) |    \
                                     PIN_OTYPE_PUSHPULL(GPIOB_ULPI_D5) |    \
                                     PIN_OTYPE_PUSHPULL(GPIOB_ULPI_D6) |    \
                                     PIN_OTYPE_PUSHPULL(GPIOB_PIN14) |      \
                                     PIN_OTYPE_PUSHPULL(GPIOB_PIN15))
#define VAL_GPIOB_OSPEEDR           (PIN_OSPEED_100M(GPIOB_ULPI_D1) |       \
                                     PIN_OSPEED_100M(GPIOB_ULPI_D2) |       \
                                     PIN_OSPEED_2M(GPIOB_PIN2) |            \
                                     PIN_OSPEED_100M(GPIOB_CARD_SCK) |      \
                                     PIN_OSPEED_2M(GPIOB_PIN4) |            \
                                     PIN_OSPEED_100M(GPIOB_ULPI_D7) |       \
                                     PIN_OSPEED_100M(GPIOB_USART1_TX) |     \
                                     PIN_OSPEED_100M(GPIOB_USART1_RX) |     \
                                     PIN_OSPEED_100M(GPIOB_I2C_SCL) |       \
                                     PIN_OSPEED_100M(GPIOB_I2C_SDA) |       \
                                     PIN_OSPEED_100M(GPIOB_ULPI_D3) |       \
                                     PIN_OSPEED_100M(GPIOB_ULPI_D4) |       \
                                     PIN_OSPEED_100M(GPIOB_ULPI_D5) |       \
                                     PIN_OSPEED_100M(GPIOB_ULPI_D6) |       \
                                     PIN_OSPEED_2M(GPIOB_PIN14) |           \
                                     PIN_OSPEED_2M(GPIOB_PIN15))
#define VAL_GPIOB_PUPDR             (PIN_PUPDR_FLOATING(GPIOB_ULPI_D1) |    \
                                     PIN_PUPDR_FLOATING(GPIOB_ULPI_D2) |    \
                                     PIN_PUPDR_PULLUP(GPIOB_PIN2) |         \
                                     PIN_PUPDR_FLOATING(GPIOB_CARD_SCK) |   \
                                     PIN_PUPDR_PULLUP(GPIOB_PIN4) |         \
                                     PIN_PUPDR_FLOATING(GPIOB_ULPI_D7) |    \
                                     PIN_PUPDR_FLOATING(GPIOB_USART1_TX) |  \
                                     PIN_PUPDR_FLOATING(GPIOB_USART1_RX) |  \
                                     PIN_PUPDR_FLOATING(GPIOB_I2C_SCL) |    \
                                     PIN_PUPDR_FLOATING(GPIOB_I2C_SDA) |    \
                                     PIN_PUPDR_FLOATING(GPIOB_ULPI_D3) |    \
                                     PIN_PUPDR_FLOATING(GPIOB_ULPI_D4) |    \
                                     PIN_PUPDR_FLOATING(GPIOB_ULPI_D5) |    \
                                     PIN_PUPDR_FLOATING(GPIOB_ULPI_D6) |    \
                                     PIN_PUPDR_PULLUP(GPIOB_PIN14) |        \
                                     PIN_PUPDR_PULLUP(GPIOB_PIN15))
#define VAL_GPIOB_ODR               (PIN_ODR_HIGH(GPIOB_ULPI_D1) |          \
                                     PIN_ODR_HIGH(GPIOB_ULPI_D2) |          \
                                     PIN_ODR_HIGH(GPIOB_PIN2) |             \
                                     PIN_ODR_HIGH(GPIOB_CARD_SCK) |         \
                                     PIN_ODR_HIGH(GPIOB_PIN4) |             \
                                     PIN_ODR_HIGH(GPIOB_ULPI_D7) |          \
                                     PIN_ODR_HIGH(GPIOB_USART1_TX) |        \
                                     PIN_ODR_HIGH(GPIOB_USART1_RX) |        \
                                     PIN_ODR_HIGH(GPIOB_I2C_SCL) |          \
                                     PIN_ODR_HIGH(GPIOB_I2C_SDA) |          \
                                     PIN_ODR_HIGH(GPIOB_ULPI_D3) |          \
                                     PIN_ODR_HIGH(GPIOB_ULPI_D4) |          \
                                     PIN_ODR_HIGH(GPIOB_ULPI_D5) |          \
                                     PIN_ODR_HIGH(GPIOB_ULPI_D6) |          \
                                     PIN_ODR_HIGH(GPIOB_PIN14) |            \
                                     PIN_ODR_HIGH(GPIOB_PIN15))
#define VAL_GPIOB_AFRL              (PIN_AFIO_AF(GPIOB_ULPI_D1, 10) |       \
                                     PIN_AFIO_AF(GPIOB_ULPI_D2, 10) |       \
                                     PIN_AFIO_AF(GPIOB_PIN2, 0) |           \
                                     PIN_AFIO_AF(GPIOB_CARD_SCK, 5) |       \
                                     PIN_AFIO_AF(GPIOB_PIN4, 0) |           \
                                     PIN_AFIO_AF(GPIOB_ULPI_D7, 10) |       \
                                     PIN_AFIO_AF(GPIOB_USART1_TX, 7) |      \
                                     PIN_AFIO_AF(GPIOB_USART1_RX, 7))
#define VAL_GPIOB_AFRH              (PIN_AFIO_AF(GPIOB_I2C_SCL, 4) |        \
                                     PIN_AFIO_AF(GPIOB_I2C_SDA, 4) |        \
                                     PIN_AFIO_AF(GPIOB_ULPI_D3, 10) |       \
                                     PIN_AFIO_AF(GPIOB_ULPI_D4, 10) |       \
                                     PIN_AFIO_AF(GPIOB_ULPI_D5, 10) |       \
                                     PIN_AFIO_AF(GPIOB_ULPI_D6, 10) |       \
                                     PIN_AFIO_AF(GPIOB_PIN14, 0) |          \
                                     PIN_AFIO_AF(GPIOB_PIN15, 0))

/*
 * GPIOC setup:
 *
 * PC0  - ULPI_STP                  (alternate 10).
 * PC1  - PIN1                      (input pullup).
 * PC2  - ULPI_DIR                  (alternate 10).
 * PC3  - ULPI_NXT                  (alternate 10).
 * PC4  - PIN4                      (input pullup).
 * PC5  - PIN5                      (input pullup).
 * PC6  - PIN6                      (input pullup).
 * PC7  - PIN7                      (input pullup).
 * PC8  - MCK_EN                    (output pushpull maximum).
 * PC9  - I2S_MCK                   (alternate 5).
 * PC10 - I2S_BCK                   (alternate 6).
 * PC11 - I2S_SEL                   (output pushpull maximum).
 * PC12 - I2S_SD                    (alternate 6).
 * PC13 - PIN13                     (input pullup).
 * PC14 - PIN14                     (input pullup).
 * PC15 - PIN15                     (input pullup).
 */
#define VAL_GPIOC_MODER             (PIN_MODE_ALTERNATE(GPIOC_ULPI_STP) |   \
                                     PIN_MODE_INPUT(GPIOC_PIN1) |           \
                                     PIN_MODE_ALTERNATE(GPIOC_ULPI_DIR) |   \
                                     PIN_MODE_ALTERNATE(GPIOC_ULPI_NXT) |   \
                                     PIN_MODE_INPUT(GPIOC_PIN4) |           \
                                     PIN_MODE_INPUT(GPIOC_PIN5) |           \
                                     PIN_MODE_INPUT(GPIOC_PIN6) |           \
                                     PIN_MODE_ALTERNATE(GPIOC_PIN7) |           \
                                     PIN_MODE_OUTPUT(GPIOC_MCK_EN) |        \
                                     PIN_MODE_ALTERNATE(GPIOC_I2S_MCK) |    \
                                     PIN_MODE_ALTERNATE(GPIOC_I2S_BCK) |    \
                                     PIN_MODE_OUTPUT(GPIOC_I2S_SEL) |       \
                                     PIN_MODE_ALTERNATE(GPIOC_I2S_SD) |     \
                                     PIN_MODE_INPUT(GPIOC_PIN13) |          \
                                     PIN_MODE_INPUT(GPIOC_PIN14) |          \
                                     PIN_MODE_INPUT(GPIOC_PIN15))
#define VAL_GPIOC_OTYPER            (PIN_OTYPE_PUSHPULL(GPIOC_ULPI_STP) |   \
                                     PIN_OTYPE_PUSHPULL(GPIOC_PIN1) |       \
                                     PIN_OTYPE_PUSHPULL(GPIOC_ULPI_DIR) |   \
                                     PIN_OTYPE_PUSHPULL(GPIOC_ULPI_NXT) |   \
                                     PIN_OTYPE_PUSHPULL(GPIOC_PIN4) |       \
                                     PIN_OTYPE_PUSHPULL(GPIOC_PIN5) |       \
                                     PIN_OTYPE_PUSHPULL(GPIOC_PIN6) |       \
                                     PIN_OTYPE_PUSHPULL(GPIOC_PIN7) |       \
                                     PIN_OTYPE_PUSHPULL(GPIOC_MCK_EN) |     \
                                     PIN_OTYPE_PUSHPULL(GPIOC_I2S_MCK) |    \
                                     PIN_OTYPE_PUSHPULL(GPIOC_I2S_BCK) |    \
                                     PIN_OTYPE_PUSHPULL(GPIOC_I2S_SEL) |    \
                                     PIN_OTYPE_PUSHPULL(GPIOC_I2S_SD) |     \
                                     PIN_OTYPE_PUSHPULL(GPIOC_PIN13) |      \
                                     PIN_OTYPE_PUSHPULL(GPIOC_PIN14) |      \
                                     PIN_OTYPE_PUSHPULL(GPIOC_PIN15))
#define VAL_GPIOC_OSPEEDR           (PIN_OSPEED_100M(GPIOC_ULPI_STP) |      \
                                     PIN_OSPEED_2M(GPIOC_PIN1) |            \
                                     PIN_OSPEED_100M(GPIOC_ULPI_DIR) |      \
                                     PIN_OSPEED_100M(GPIOC_ULPI_NXT) |      \
                                     PIN_OSPEED_2M(GPIOC_PIN4) |            \
                                     PIN_OSPEED_2M(GPIOC_PIN5) |            \
                                     PIN_OSPEED_2M(GPIOC_PIN6) |            \
                                     PIN_OSPEED_100M(GPIOC_PIN7) |            \
                                     PIN_OSPEED_100M(GPIOC_MCK_EN) |        \
                                     PIN_OSPEED_100M(GPIOC_I2S_MCK) |       \
                                     PIN_OSPEED_100M(GPIOC_I2S_BCK) |       \
                                     PIN_OSPEED_100M(GPIOC_I2S_SEL) |       \
                                     PIN_OSPEED_100M(GPIOC_I2S_SD) |        \
                                     PIN_OSPEED_2M(GPIOC_PIN13) |           \
                                     PIN_OSPEED_2M(GPIOC_PIN14) |           \
                                     PIN_OSPEED_2M(GPIOC_PIN15))
#define VAL_GPIOC_PUPDR             (PIN_PUPDR_FLOATING(GPIOC_ULPI_STP) |   \
                                     PIN_PUPDR_PULLUP(GPIOC_PIN1) |         \
                                     PIN_PUPDR_FLOATING(GPIOC_ULPI_DIR) |   \
                                     PIN_PUPDR_FLOATING(GPIOC_ULPI_NXT) |   \
                                     PIN_PUPDR_PULLUP(GPIOC_PIN4) |         \
                                     PIN_PUPDR_PULLUP(GPIOC_PIN5) |         \
                                     PIN_PUPDR_PULLUP(GPIOC_PIN6) |         \
                                     PIN_PUPDR_FLOATING(GPIOC_PIN7) |         \
                                     PIN_PUPDR_FLOATING(GPIOC_MCK_EN) |     \
                                     PIN_PUPDR_FLOATING(GPIOC_I2S_MCK) |    \
                                     PIN_PUPDR_PULLUP(GPIOC_I2S_BCK) |      \
                                     PIN_PUPDR_FLOATING(GPIOC_I2S_SEL) |    \
                                     PIN_PUPDR_FLOATING(GPIOC_I2S_SD) |     \
                                     PIN_PUPDR_PULLUP(GPIOC_PIN13) |        \
                                     PIN_PUPDR_PULLUP(GPIOC_PIN14) |        \
                                     PIN_PUPDR_PULLUP(GPIOC_PIN15))
#define VAL_GPIOC_ODR               (PIN_ODR_HIGH(GPIOC_ULPI_STP) |         \
                                     PIN_ODR_HIGH(GPIOC_PIN1) |             \
                                     PIN_ODR_HIGH(GPIOC_ULPI_DIR) |         \
                                     PIN_ODR_HIGH(GPIOC_ULPI_NXT) |         \
                                     PIN_ODR_HIGH(GPIOC_PIN4) |             \
                                     PIN_ODR_HIGH(GPIOC_PIN5) |             \
                                     PIN_ODR_HIGH(GPIOC_PIN6) |             \
                                     PIN_ODR_HIGH(GPIOC_PIN7) |             \
                                     PIN_ODR_LOW(GPIOC_MCK_EN) |            \
                                     PIN_ODR_HIGH(GPIOC_I2S_MCK) |          \
                                     PIN_ODR_HIGH(GPIOC_I2S_BCK) |          \
                                     PIN_ODR_LOW(GPIOC_I2S_SEL) |           \
                                     PIN_ODR_HIGH(GPIOC_I2S_SD) |           \
                                     PIN_ODR_HIGH(GPIOC_PIN13) |            \
                                     PIN_ODR_HIGH(GPIOC_PIN14) |            \
                                     PIN_ODR_HIGH(GPIOC_PIN15))
#define VAL_GPIOC_AFRL              (PIN_AFIO_AF(GPIOC_ULPI_STP, 10) |      \
                                     PIN_AFIO_AF(GPIOC_PIN1, 0) |           \
                                     PIN_AFIO_AF(GPIOC_ULPI_DIR, 10) |      \
                                     PIN_AFIO_AF(GPIOC_ULPI_NXT, 10) |      \
                                     PIN_AFIO_AF(GPIOC_PIN4, 0) |           \
                                     PIN_AFIO_AF(GPIOC_PIN5, 0) |           \
                                     PIN_AFIO_AF(GPIOC_PIN6, 0) |           \
                                     PIN_AFIO_AF(GPIOC_PIN7, 6))
#define VAL_GPIOC_AFRH              (PIN_AFIO_AF(GPIOC_MCK_EN, 0) |         \
                                     PIN_AFIO_AF(GPIOC_I2S_MCK, 5) |        \
                                     PIN_AFIO_AF(GPIOC_I2S_BCK, 6) |        \
                                     PIN_AFIO_AF(GPIOC_I2S_SEL, 0) |        \
                                     PIN_AFIO_AF(GPIOC_I2S_SD, 6) |         \
                                     PIN_AFIO_AF(GPIOC_PIN13, 0) |          \
                                     PIN_AFIO_AF(GPIOC_PIN14, 0) |          \
                                     PIN_AFIO_AF(GPIOC_PIN15, 0))

/*
 * GPIOD setup:
 *
 * PD0  - PIN0                      (input pullup).
 * PD1  - PIN1                      (input pullup).
 * PD2  - PIN2                      (input pullup).
 * PD3  - PIN3                      (input pullup).
 * PD4  - PIN4                      (input pullup).
 * PD5  - PIN5                      (input pullup).
 * PD6  - PIN6                      (input pullup).
 * PD7  - PIN7                      (input pullup).
 * PD8  - PIN8                      (input pullup).
 * PD9  - PIN9                      (input pullup).
 * PD10 - PIN10                     (input pullup).
 * PD11 - PIN11                     (input pullup).
 * PD12 - ENCODER_LEFT              (alternate 2).
 * PD13 - ENCODER_RIGHT             (alternate 2).
 * PD14 - ENCODER_CLICK             (input pullup).
 * PD15 - PIN15                     (input pullup).
 */
#define VAL_GPIOD_MODER             (PIN_MODE_INPUT(GPIOD_PIN0) |           \
                                     PIN_MODE_INPUT(GPIOD_PIN1) |           \
                                     PIN_MODE_INPUT(GPIOD_PIN2) |           \
                                     PIN_MODE_INPUT(GPIOD_PIN3) |           \
                                     PIN_MODE_INPUT(GPIOD_PIN4) |           \
                                     PIN_MODE_INPUT(GPIOD_PIN5) |           \
                                     PIN_MODE_INPUT(GPIOD_PIN6) |           \
                                     PIN_MODE_INPUT(GPIOD_PIN7) |           \
                                     PIN_MODE_INPUT(GPIOD_PIN8) |           \
                                     PIN_MODE_INPUT(GPIOD_PIN9) |           \
                                     PIN_MODE_INPUT(GPIOD_PIN10) |          \
                                     PIN_MODE_INPUT(GPIOD_PIN11) |          \
                                     PIN_MODE_ALTERNATE(GPIOD_ENCODER_LEFT) |\
                                     PIN_MODE_ALTERNATE(GPIOD_ENCODER_RIGHT) |\
                                     PIN_MODE_INPUT(GPIOD_ENCODER_CLICK) |  \
                                     PIN_MODE_INPUT(GPIOD_PIN15))
#define VAL_GPIOD_OTYPER            (PIN_OTYPE_PUSHPULL(GPIOD_PIN0) |       \
                                     PIN_OTYPE_PUSHPULL(GPIOD_PIN1) |       \
                                     PIN_OTYPE_PUSHPULL(GPIOD_PIN2) |       \
                                     PIN_OTYPE_PUSHPULL(GPIOD_PIN3) |       \
                                     PIN_OTYPE_PUSHPULL(GPIOD_PIN4) |       \
                                     PIN_OTYPE_PUSHPULL(GPIOD_PIN5) |       \
                                     PIN_OTYPE_PUSHPULL(GPIOD_PIN6) |       \
                                     PIN_OTYPE_PUSHPULL(GPIOD_PIN7) |       \
                                     PIN_OTYPE_PUSHPULL(GPIOD_PIN8) |       \
                                     PIN_OTYPE_PUSHPULL(GPIOD_PIN9) |       \
                                     PIN_OTYPE_PUSHPULL(GPIOD_PIN10) |      \
                                     PIN_OTYPE_PUSHPULL(GPIOD_PIN11) |      \
                                     PIN_OTYPE_PUSHPULL(GPIOD_ENCODER_LEFT) |\
                                     PIN_OTYPE_PUSHPULL(GPIOD_ENCODER_RIGHT) |\
                                     PIN_OTYPE_PUSHPULL(GPIOD_ENCODER_CLICK) |\
                                     PIN_OTYPE_PUSHPULL(GPIOD_PIN15))
#define VAL_GPIOD_OSPEEDR           (PIN_OSPEED_2M(GPIOD_PIN0) |            \
                                     PIN_OSPEED_2M(GPIOD_PIN1) |            \
                                     PIN_OSPEED_2M(GPIOD_PIN2) |            \
                                     PIN_OSPEED_2M(GPIOD_PIN3) |            \
                                     PIN_OSPEED_2M(GPIOD_PIN4) |            \
                                     PIN_OSPEED_2M(GPIOD_PIN5) |            \
                                     PIN_OSPEED_2M(GPIOD_PIN6) |            \
                                     PIN_OSPEED_2M(GPIOD_PIN7) |            \
                                     PIN_OSPEED_2M(GPIOD_PIN8) |            \
                                     PIN_OSPEED_2M(GPIOD_PIN9) |            \
                                     PIN_OSPEED_2M(GPIOD_PIN10) |           \
                                     PIN_OSPEED_2M(GPIOD_PIN11) |           \
                                     PIN_OSPEED_100M(GPIOD_ENCODER_LEFT) |  \
                                     PIN_OSPEED_100M(GPIOD_ENCODER_RIGHT) | \
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
                                     PIN_AFIO_AF(GPIOG_PIN13, 0) |          \
                                     PIN_AFIO_AF(GPIOG_PIN14, 0) |          \
                                     PIN_AFIO_AF(GPIOG_PIN15, 0))

/*
 * GPIOH setup:
 *
 * PH0  - OSC_IN                    (input floating).
 * PH1  - OSC_OUT                   (input floating).
 * PH2  - PIN2                      (input pullup).
 * PH3  - PIN3                      (input pullup).
 * PH4  - PIN4                      (input pullup).
 * PH5  - PIN5                      (input pullup).
 * PH6  - PIN6                      (input pullup).
 * PH7  - PIN7                      (input pullup).
 * PH8  - PIN8                      (input pullup).
 * PH9  - PIN9                      (input pullup).
 * PH10 - PIN10                     (input pullup).
 * PH11 - PIN11                     (input pullup).
 * PH12 - PIN12                     (input pullup).
 * PH13 - PIN13                     (input pullup).
 * PH14 - PIN14                     (input pullup).
 * PH15 - PIN15                     (input pullup).
 */
#define VAL_GPIOH_MODER             (PIN_MODE_INPUT(GPIOH_OSC_IN) |         \
                                     PIN_MODE_INPUT(GPIOH_OSC_OUT) |        \
                                     PIN_MODE_INPUT(GPIOH_PIN2) |           \
                                     PIN_MODE_INPUT(GPIOH_PIN3) |           \
                                     PIN_MODE_INPUT(GPIOH_PIN4) |           \
                                     PIN_MODE_INPUT(GPIOH_PIN5) |           \
                                     PIN_MODE_INPUT(GPIOH_PIN6) |           \
                                     PIN_MODE_INPUT(GPIOH_PIN7) |           \
                                     PIN_MODE_INPUT(GPIOH_PIN8) |           \
                                     PIN_MODE_INPUT(GPIOH_PIN9) |           \
                                     PIN_MODE_INPUT(GPIOH_PIN10) |          \
                                     PIN_MODE_INPUT(GPIOH_PIN11) |          \
                                     PIN_MODE_INPUT(GPIOH_PIN12) |          \
                                     PIN_MODE_INPUT(GPIOH_PIN13) |          \
                                     PIN_MODE_INPUT(GPIOH_PIN14) |          \
                                     PIN_MODE_INPUT(GPIOH_PIN15))
#define VAL_GPIOH_OTYPER            (PIN_OTYPE_PUSHPULL(GPIOH_OSC_IN) |     \
                                     PIN_OTYPE_PUSHPULL(GPIOH_OSC_OUT) |    \
                                     PIN_OTYPE_PUSHPULL(GPIOH_PIN2) |       \
                                     PIN_OTYPE_PUSHPULL(GPIOH_PIN3) |       \
                                     PIN_OTYPE_PUSHPULL(GPIOH_PIN4) |       \
                                     PIN_OTYPE_PUSHPULL(GPIOH_PIN5) |       \
                                     PIN_OTYPE_PUSHPULL(GPIOH_PIN6) |       \
                                     PIN_OTYPE_PUSHPULL(GPIOH_PIN7) |       \
                                     PIN_OTYPE_PUSHPULL(GPIOH_PIN8) |       \
                                     PIN_OTYPE_PUSHPULL(GPIOH_PIN9) |       \
                                     PIN_OTYPE_PUSHPULL(GPIOH_PIN10) |      \
                                     PIN_OTYPE_PUSHPULL(GPIOH_PIN11) |      \
                                     PIN_OTYPE_PUSHPULL(GPIOH_PIN12) |      \
                                     PIN_OTYPE_PUSHPULL(GPIOH_PIN13) |      \
                                     PIN_OTYPE_PUSHPULL(GPIOH_PIN14) |      \
                                     PIN_OTYPE_PUSHPULL(GPIOH_PIN15))
#define VAL_GPIOH_OSPEEDR           (PIN_OSPEED_100M(GPIOH_OSC_IN) |        \
                                     PIN_OSPEED_100M(GPIOH_OSC_OUT) |       \
                                     PIN_OSPEED_2M(GPIOH_PIN2) |            \
                                     PIN_OSPEED_2M(GPIOH_PIN3) |            \
                                     PIN_OSPEED_2M(GPIOH_PIN4) |            \
                                     PIN_OSPEED_2M(GPIOH_PIN5) |            \
                                     PIN_OSPEED_2M(GPIOH_PIN6) |            \
                                     PIN_OSPEED_2M(GPIOH_PIN7) |            \
                                     PIN_OSPEED_2M(GPIOH_PIN8) |            \
                                     PIN_OSPEED_2M(GPIOH_PIN9) |            \
                                     PIN_OSPEED_2M(GPIOH_PIN10) |           \
                                     PIN_OSPEED_2M(GPIOH_PIN11) |           \
                                     PIN_OSPEED_2M(GPIOH_PIN12) |           \
                                     PIN_OSPEED_2M(GPIOH_PIN13) |           \
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
                                     PIN_PUPDR_PULLUP(GPIOI_PIN14) |        \
                                     PIN_PUPDR_PULLUP(GPIOI_PIN15))
#define VAL_GPIOI_ODR               (PIN_ODR_HIGH(GPIOI_PIN0) |             \
                                     PIN_ODR_HIGH(GPIOI_PIN1) |             \
                                     PIN_ODR_HIGH(GPIOI_PIN2) |             \
                                     PIN_ODR_HIGH(GPIOI_PIN3) |             \
                                     PIN_ODR_HIGH(GPIOI_PIN4) |             \
                                     PIN_ODR_HIGH(GPIOI_PIN5) |             \
                                     PIN_ODR_HIGH(GPIOI_PIN6) |             \
                                     PIN_ODR_HIGH(GPIOI_PIN7) |             \
                                     PIN_ODR_HIGH(GPIOI_PIN8) |             \
                                     PIN_ODR_HIGH(GPIOI_PIN9) |             \
                                     PIN_ODR_HIGH(GPIOI_PIN10) |            \
                                     PIN_ODR_HIGH(GPIOI_PIN11) |            \
                                     PIN_ODR_HIGH(GPIOI_PIN12) |            \
                                     PIN_ODR_HIGH(GPIOI_PIN13) |            \
                                     PIN_ODR_HIGH(GPIOI_PIN14) |            \
                                     PIN_ODR_HIGH(GPIOI_PIN15))
#define VAL_GPIOI_AFRL              (PIN_AFIO_AF(GPIOI_PIN0, 0) |           \
                                     PIN_AFIO_AF(GPIOI_PIN1, 0) |           \
                                     PIN_AFIO_AF(GPIOI_PIN2, 0) |           \
                                     PIN_AFIO_AF(GPIOI_PIN3, 0) |           \
                                     PIN_AFIO_AF(GPIOI_PIN4, 0) |           \
                                     PIN_AFIO_AF(GPIOI_PIN5, 0) |           \
                                     PIN_AFIO_AF(GPIOI_PIN6, 0) |           \
                                     PIN_AFIO_AF(GPIOI_PIN7, 0))
#define VAL_GPIOI_AFRH              (PIN_AFIO_AF(GPIOI_PIN8, 0) |           \
                                     PIN_AFIO_AF(GPIOI_PIN9, 0) |           \
                                     PIN_AFIO_AF(GPIOI_PIN10, 0) |          \
                                     PIN_AFIO_AF(GPIOI_PIN11, 0) |          \
                                     PIN_AFIO_AF(GPIOI_PIN12, 0) |          \
                                     PIN_AFIO_AF(GPIOI_PIN13, 0) |          \
                                     PIN_AFIO_AF(GPIOI_PIN14, 0) |          \
                                     PIN_AFIO_AF(GPIOI_PIN15, 0))


#if !defined(_FROM_ASM_)
#ifdef __cplusplus
extern "C" {
#endif
void boardInit(void);
#ifdef __cplusplus
}
#endif
#endif /* _FROM_ASM_ */

#endif /* _BOARD_H_ */
