Blizbor/KDAC/(commit log)

2015-05-27 Initial commit.
    [converter.sch, dac.kicad_pcb, dac.sch, mcu.sch, power-switching.sch, power.kicad_pcb, power.sch, spdif.sch]
2015-05-27 PCB bugfixes.
    [dac.kicad_pcb]
2015-05-27 Gerbers & pdf schematic.
    [dac.kicad_pcb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]
2015-09-14 Initial software commit.
    Firmware will be based on ChibiOS/ChibiOS RTOS.
    Nothing useful for now, just config files and application template.
    Project uses ObKo/stm32-cmake as a build system.
2015-09-30 Start working on S/PDIF receiver driver (CS8416).
    Errata for hardware.
    [cs8416.c, cs8416.h, main.c]
2015-11-05 USB Audio.
    Based on demo project written for ChibiOS.
    It's a bit buggy and ugly.
    Only FullSpeed for now, so 96 kHz / 16 bit max.
    [board.h, gui.c, main.c, mcuconf.h, spinbox.c, system.c, system.h]
