Blizbor/KDAC/(notices)

Notices in the files:
Hardware/dac.kicad_pcb:
© Kosyak 2015
